kauailabs/nav6/schematics/nav6.JPG

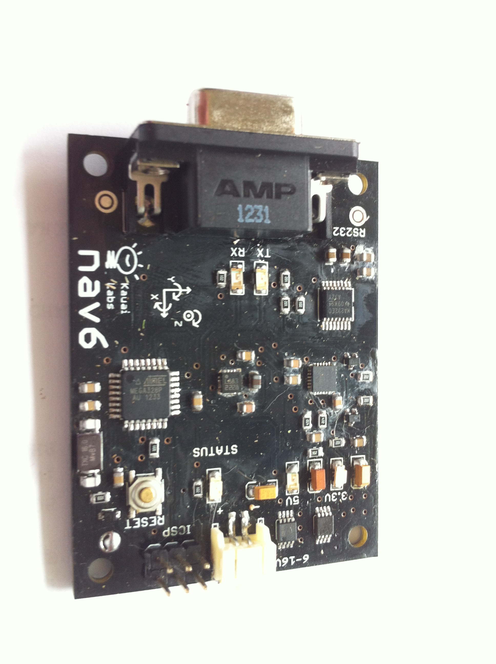
schematics/nav6.JPG
