kauailabs/nav6/images/nav6_purple_1_small_c10_highlighted.jpg

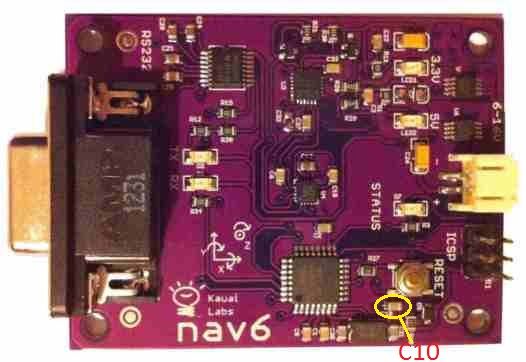
images/nav6_purple_1_small_c10_highlighted.jpg
