kauailabs/nav6/enclosure/enclosure.png

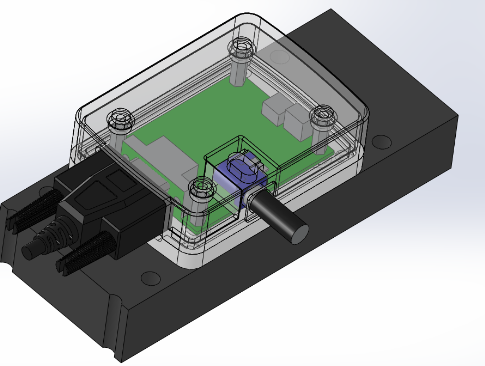
enclosure/enclosure.png
