kauailabs/nav6/enclosure/exploded.png

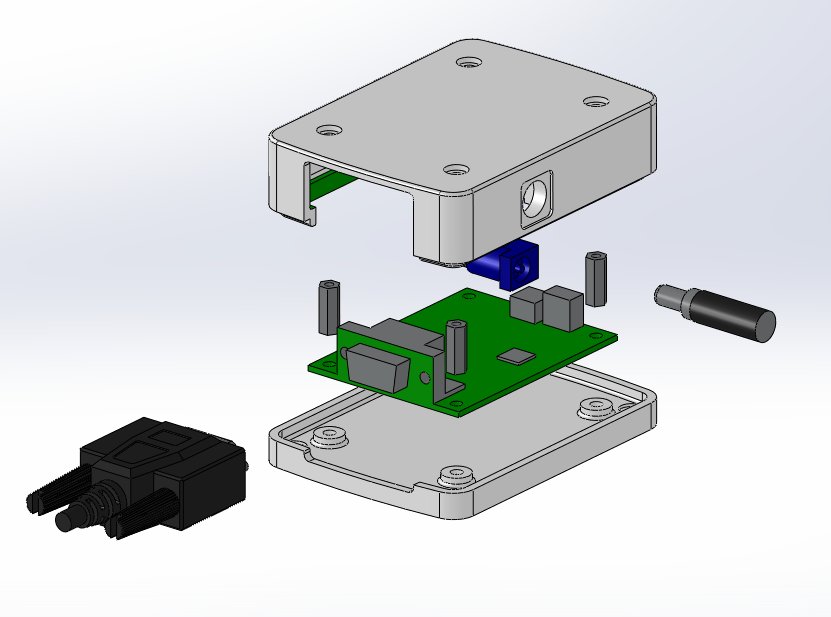
enclosure/exploded.png
