kauailabs/nav6/enclosure/exploded_angle.png

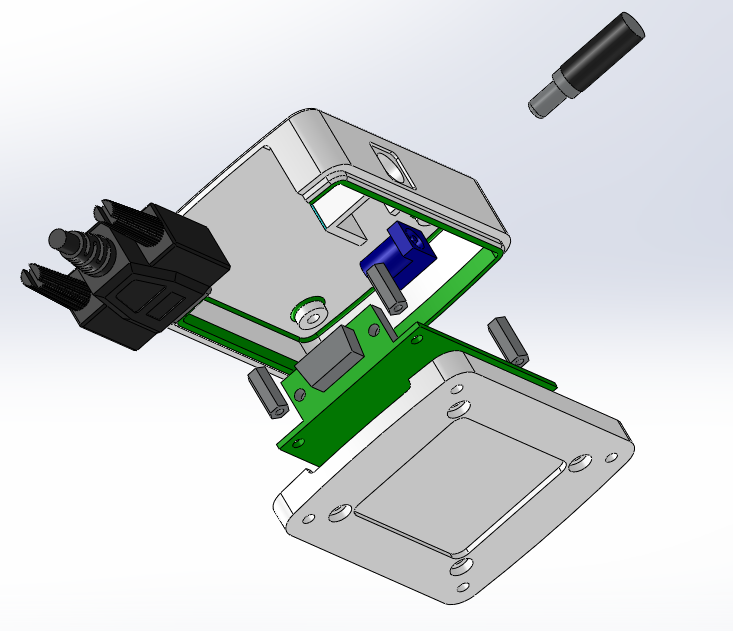
enclosure/exploded_angle.png
