kauailabs/nav6/images/db9_dtr_pin_removed.jpg

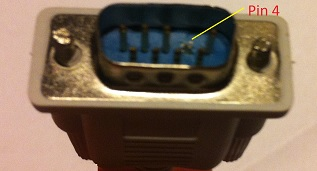
images/db9_dtr_pin_removed.jpg
