kauailabs/nav6/images/FRCMounting.png

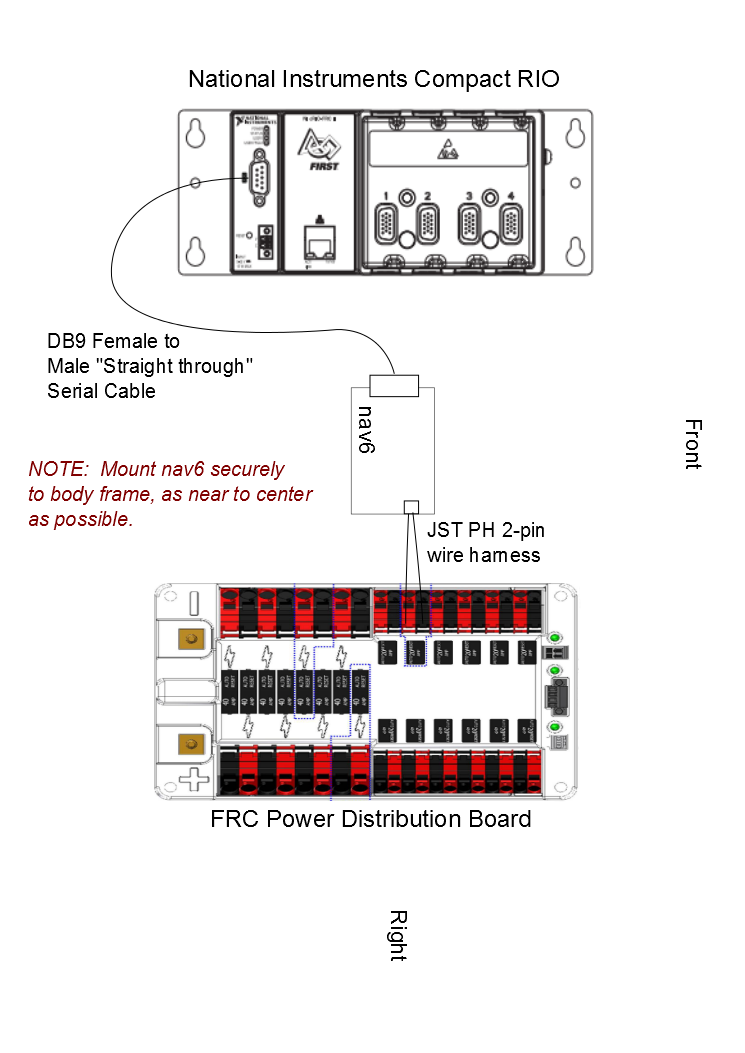
images/FRCMounting.png
