kauailabs/nav6/images/nav6_Label300.png

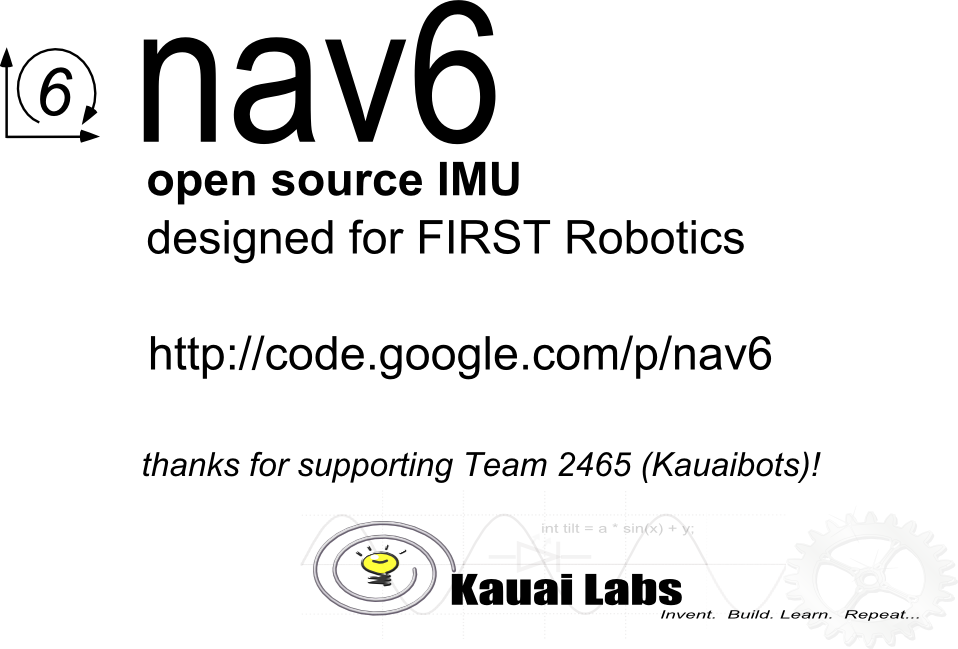
images/nav6_Label300.png
