kauailabs/nav6/images/nav6_Label.png

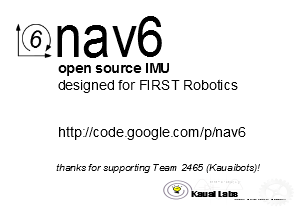
images/nav6_Label.png
