kauailabs/nav6/images/nav6UI.png

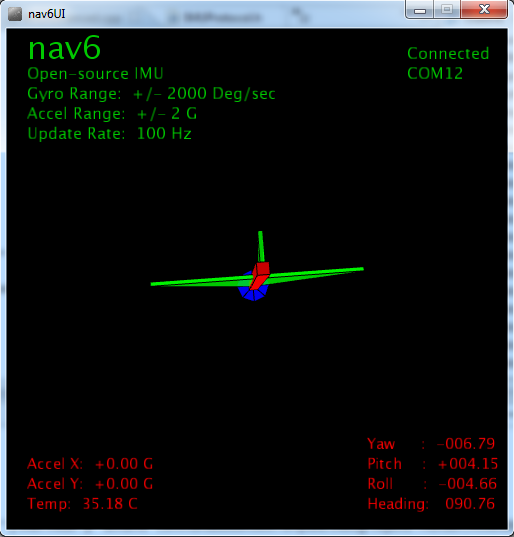
images/nav6UI.png
