kauailabs/nav6/schematics/nav6_schematic.png

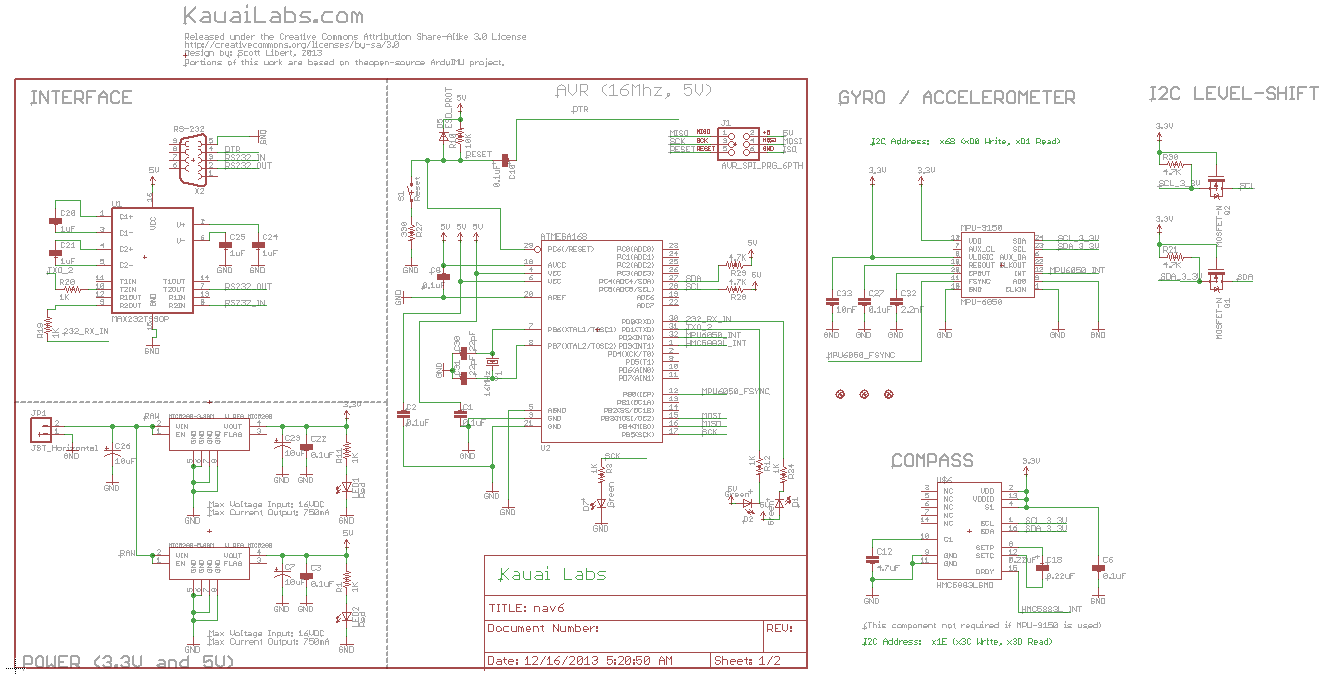
schematics/nav6_schematic.png
