kauailabs/nav6/enclosure/lid.STEP

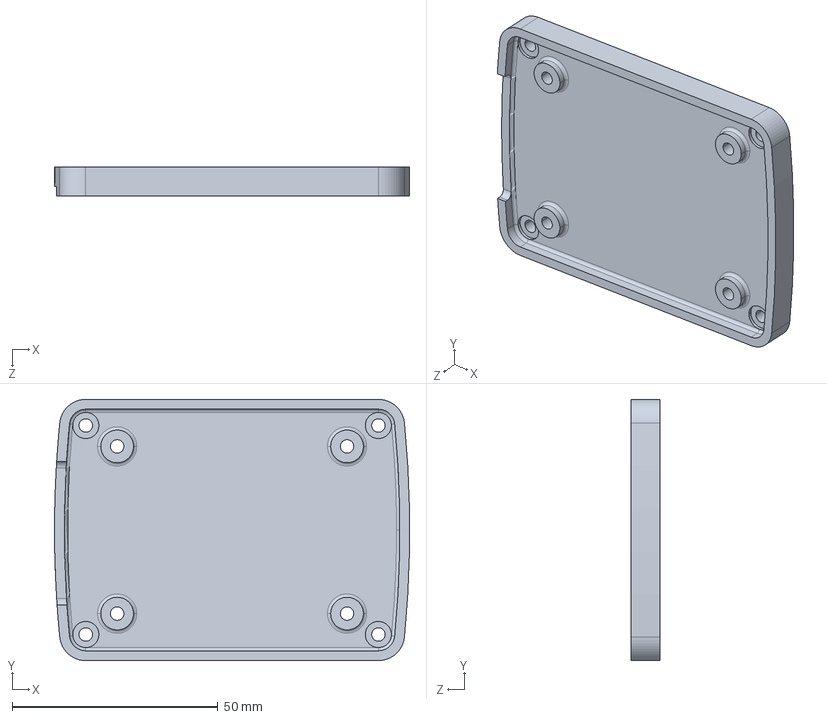
[picture p12: CAD file, 2014-02-01]
enclosure/lid.STEP
86.3 x 63.5 x 7.14 mm
