kauailabs/nav6/enclosure/base.STEP

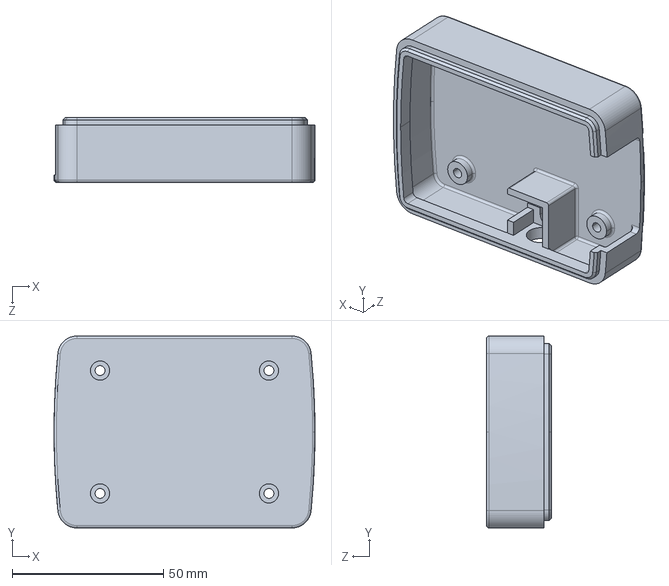
[picture p13: CAD file, 2014-02-01]
enclosure/base.STEP
86.3 x 63.5 x 21.4 mm
