kauailabs/nav6/enclosure/nav6.STL

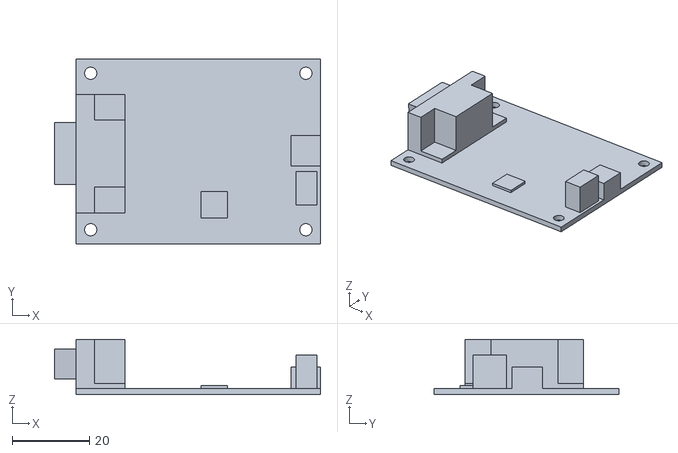
[picture p14: CAD file, 2013-12-28]
enclosure/nav6.STL
69.1 x 48.1 x 14.3
