kauailabs/nav6/(list of files, cad)

Other CAD files:
enclosure/base.STL
enclosure/lid.STL
