kauailabs/nav6/schematics/nav6.brd

## EAGLE design schematics/nav6.brd (2013-12-11)

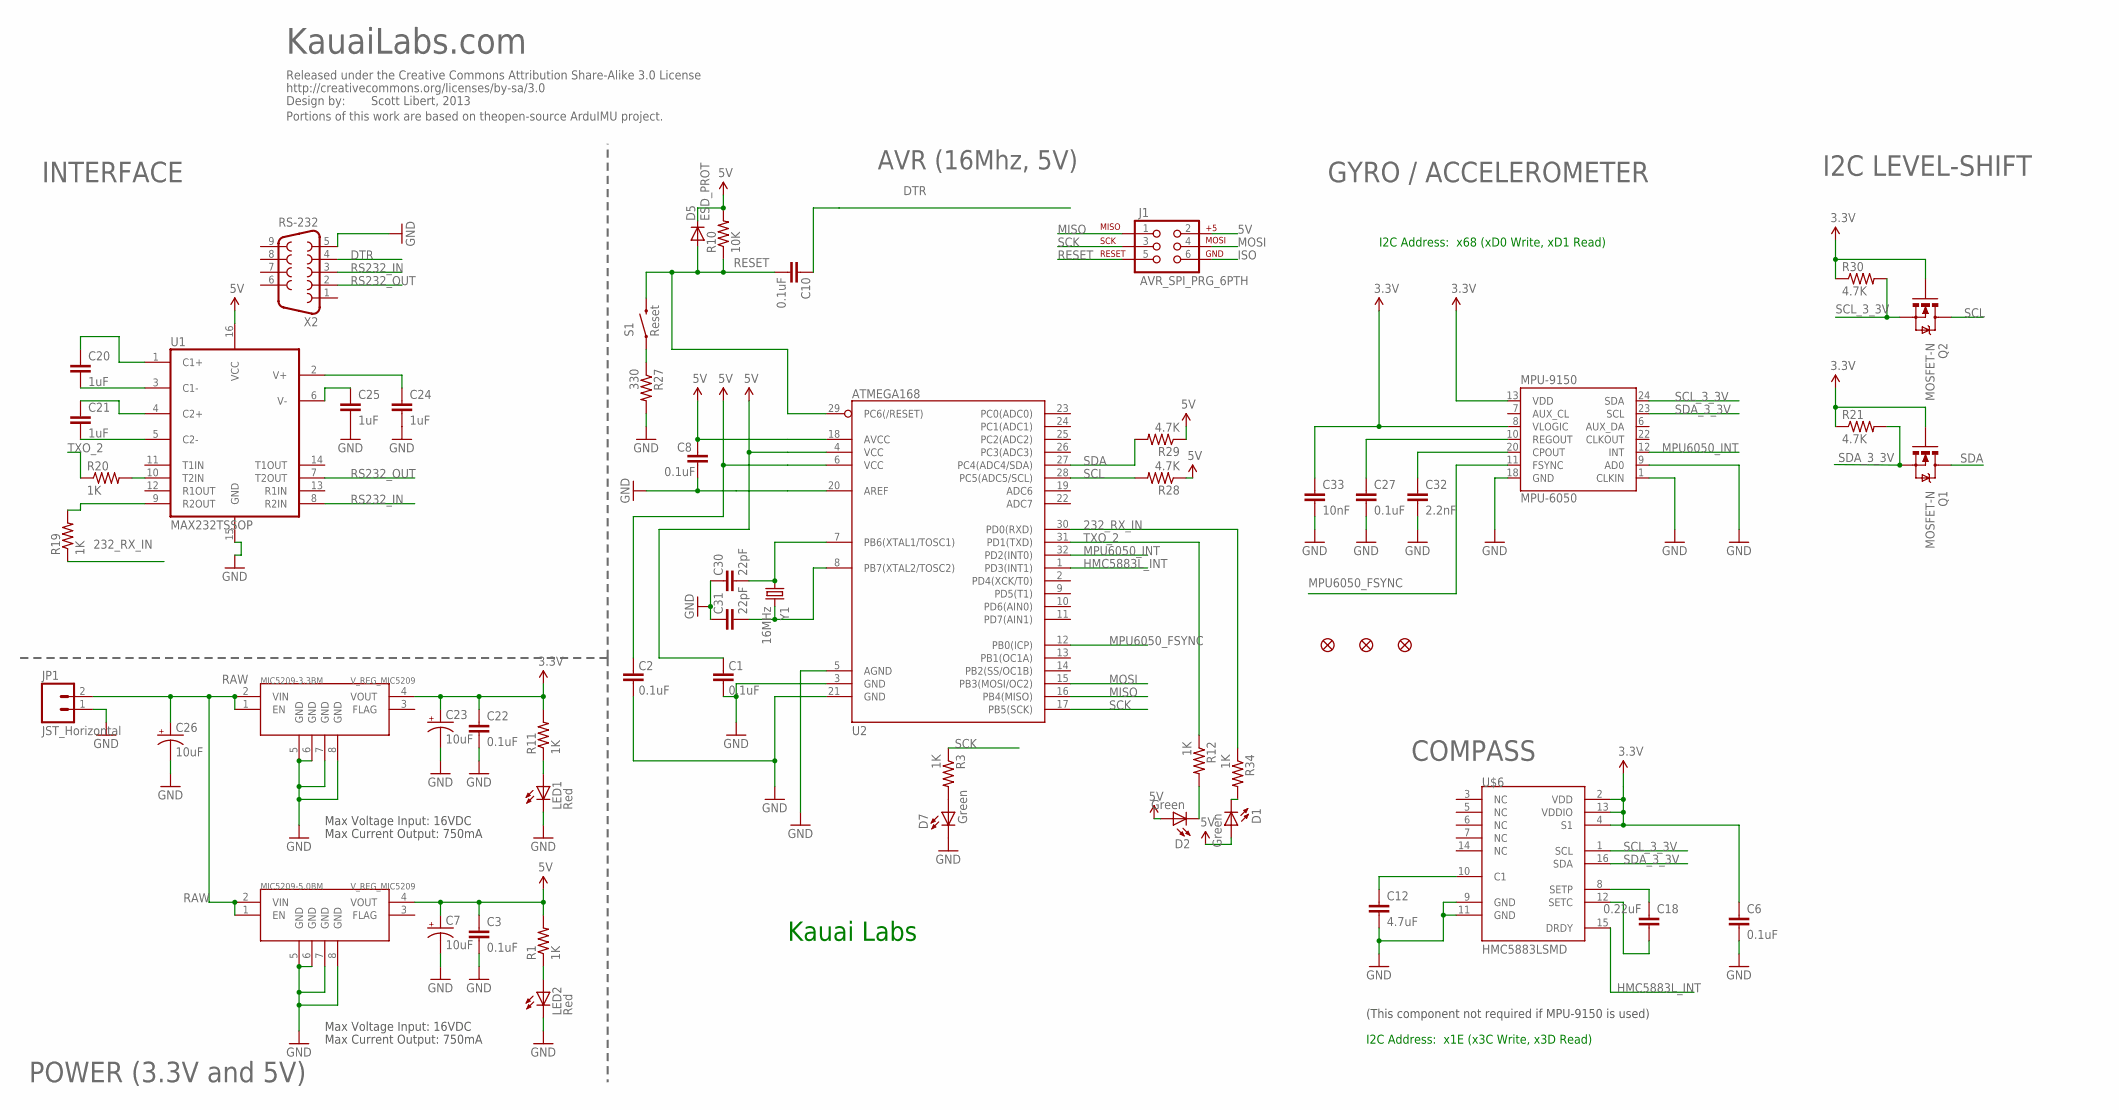
[picture p15: schematic nav6.sch, sheet 1]

Parts:
C1, C2, C3, C8, C10, C22, C27: 0.1uF; 0805
C6: 0.1uF; 0805; DIGIKEY# 445-3462-1-ND
C7, C23, C26: 10uF; EIA3216
C12: 4.7uF; 0805; DIGIKEY# 445-3457-1-ND
C18: 0.22uF; 0805; DIGIKEY# 445-1350-1-ND
C20, C21, C24, C25: 1uF; 0805
C30, C31: 22pF; 0805
C32: 2.2nF; 0805
C33: 10nF; 0805
D1, D2, D7: Green; LED-1206
D5: ESD_PROT; SOD-323
J1: AVR_SPI_PRG_6PTH; 2X3
JP1: JST_Horizontal; JST-2-SMD
JP2, JP3, JP4: FIDUCIAL1.5X3; FIDUCIAL-1.5X3
LED1, LED2: Red; LED-1206
MIC5209-3.3BM, MIC5209-5.0BM: V_REG_MIC5209; MSOP8
MPU-9150: MPU-6050; QFN24_INVENSENSE
Q1, Q2: MOSFET-N; SOT323
R1, R3, R11, R12, R19, R20, R34: 1K; 0805
R10: 10K; 0805
R21, R28, R29, R30: 4.7K; 0805
R27: 330; 0805
S1: Reset; TACTILE_SWITCH_SMD
U1: MAX232TSSOP; TSSOP16
U2: ATMEGA168; TQFP32-08
U$1: CREATIVE_COMMONS
U$6: HMC5883LSMD; 16LPCC; DIGIKEY# 342-1082-1-ND
X2: RS-232; DB9
Y1: 16MHz; CRYSTAL-TXC-7A

Connections:
3.3V: C6.1, C22.1, C23.A (+), C33.1, MIC5209-3.3BM.4 (VOUT), MPU-9150.8 (VLOGIC), MPU-9150.13 (VDD), Q1.1 (G), Q2.1 (G), R11.2, R21.1, R30.1, U$6.2 (VDD), U$6.4 (S1), U$6.13 (VDDIO)
5V: C1.2, C2.2, C3.1, C7.A (+), C8.2, D1.A, D2.A, D5.1 (C), J1.2, MIC5209-5.0BM.4 (VOUT), R1.2, R10.2, R28.1, R29.1, U1.16 (VCC), U2.4 (VCC), U2.6 (VCC), U2.18 (AVCC)
232_RX_IN: R19.1, R34.1, U2.30 (PD0(RXD))
DTR: C10.2, X2.4
HMC5883L_INT: U2.1 (PD3(INT1)), U$6.15 (DRDY)
ISO: C1.1, C2.1, C3.2, C6.2, C7.C (-), C8.1, C12.2, C22.2, C23.C (-), C24.2, C25.2, C26.C (-), C27.2, C30.2, C31.2, C32.2, C33.2, D7.C, J1.6, JP1.1, LED1.C, LED2.C, MIC5209-3.3BM.5 (GND), MIC5209-3.3BM.6 (GND), MIC5209-3.3BM.7 (GND), MIC5209-3.3BM.8 (GND), MIC5209-5.0BM.5 (GND), MIC5209-5.0BM.6 (GND), MIC5209-5.0BM.7 (GND), MIC5209-5.0BM.8 (GND), MPU-9150.1 (CLKIN), MPU-9150.9 (AD0), MPU-9150.18 (GND), R27.2, U1.15 (GND), U2.3 (GND), U2.5 (AGND), U2.20 (AREF), U2.21 (GND), U$6.9 (GND), U$6.11 (GND), X2.5
MISO: J1.1, U2.16 (PB4(MISO))
MOSI: J1.4, U2.15 (PB3(MOSI/OC2))
MPU6050_FSYNC: MPU-9150.11 (FSYNC), U2.12 (PB0(ICP))
MPU6050_INT: MPU-9150.12 (INT), U2.32 (PD2(INT0))
unnamed: C30.1, U2.7 (PB6(XTAL1/TOSC1)), Y1.P$1 (1)
unnamed: C32.1, MPU-9150.20 (CPOUT)
unnamed: LED2.A, R1.1
unnamed: C18.2, U$6.8 (SETP)
unnamed: C18.1, U$6.12 (SETC)
unnamed: C12.1, U$6.10 (C1)
unnamed: D1.C, R34.2
unnamed: D7.A, R3.2
unnamed: D2.C, R12.2
unnamed: C24.1, U1.2 (V+)
unnamed: C25.1, U1.6 (V-)
unnamed: LED1.A, R11.1
unnamed: C20.1, U1.1 (C1+)
unnamed: C20.2, U1.3 (C1-)
unnamed: C21.1, U1.4 (C2+)
unnamed: C21.2, U1.5 (C2-)
unnamed: C27.1, MPU-9150.10 (REGOUT)
unnamed: R19.2, U1.9 (R2OUT)
unnamed: R20.2, U1.10 (T2IN)
unnamed: R27.1, S1.1
unnamed: C31.1, U2.8 (PB7(XTAL2/TOSC2)), Y1.P$2 (2)
RAW: C26.A (+), JP1.2, MIC5209-3.3BM.1 (EN), MIC5209-3.3BM.2 (VIN), MIC5209-5.0BM.1 (EN), MIC5209-5.0BM.2 (VIN)
RESET: C10.1, D5.2 (A), J1.5, R10.1, S1.3 (2), U2.29 (PC6(/RESET))
RS232_IN: U1.8 (R2IN), X2.3
RS232_OUT: U1.7 (T2OUT), X2.2
SCK: J1.3, R3.1, U2.17 (PB5(SCK))
SCL: Q2.3 (D), R28.2, U2.28 (PC5(ADC5/SCL))
SCL_3_3V: MPU-9150.23 (SCL), Q2.2 (S), R30.2, U$6.1 (SCL)
SDA: Q1.3 (D), R29.2, U2.27 (PC4(ADC4/SDA))
SDA_3_3V: MPU-9150.24 (SDA), Q1.2 (S), R21.2, U$6.16 (SDA)
TXO_2: R12.1, R20.1, U2.31 (PD1(TXD))

Notes on the sheet:
Max Voltage Input: 16VDC
Max Current Output: 750mA
AVR (16Mhz, 5V)
INTERFACE
POWER (3.3V and 5V)
Kauai Labs
I2C LEVEL-SHIFT
GYRO / ACCELEROMETER
I2C Address: x68 (xD0 Write, xD1 Read)
(This component not required if MPU-9150 is used)
COMPASS
I2C Address: x1E (x3C Write, x3D Read)
KauaiLabs.com
Scott Libert, 2013
Portions of this work are based on theopen-source ArduIMU project.

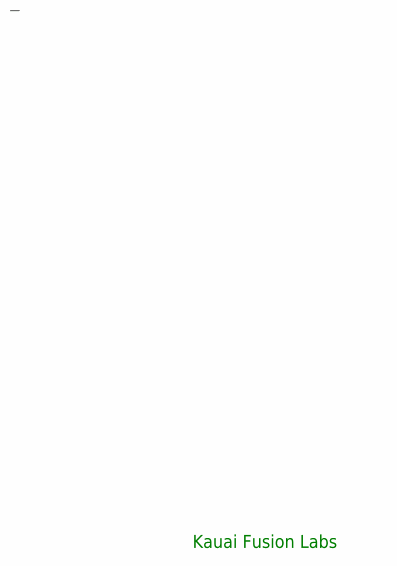
[picture p16: schematic nav6.sch, sheet 2]

Notes on the sheet:
Kauai Fusion Labs

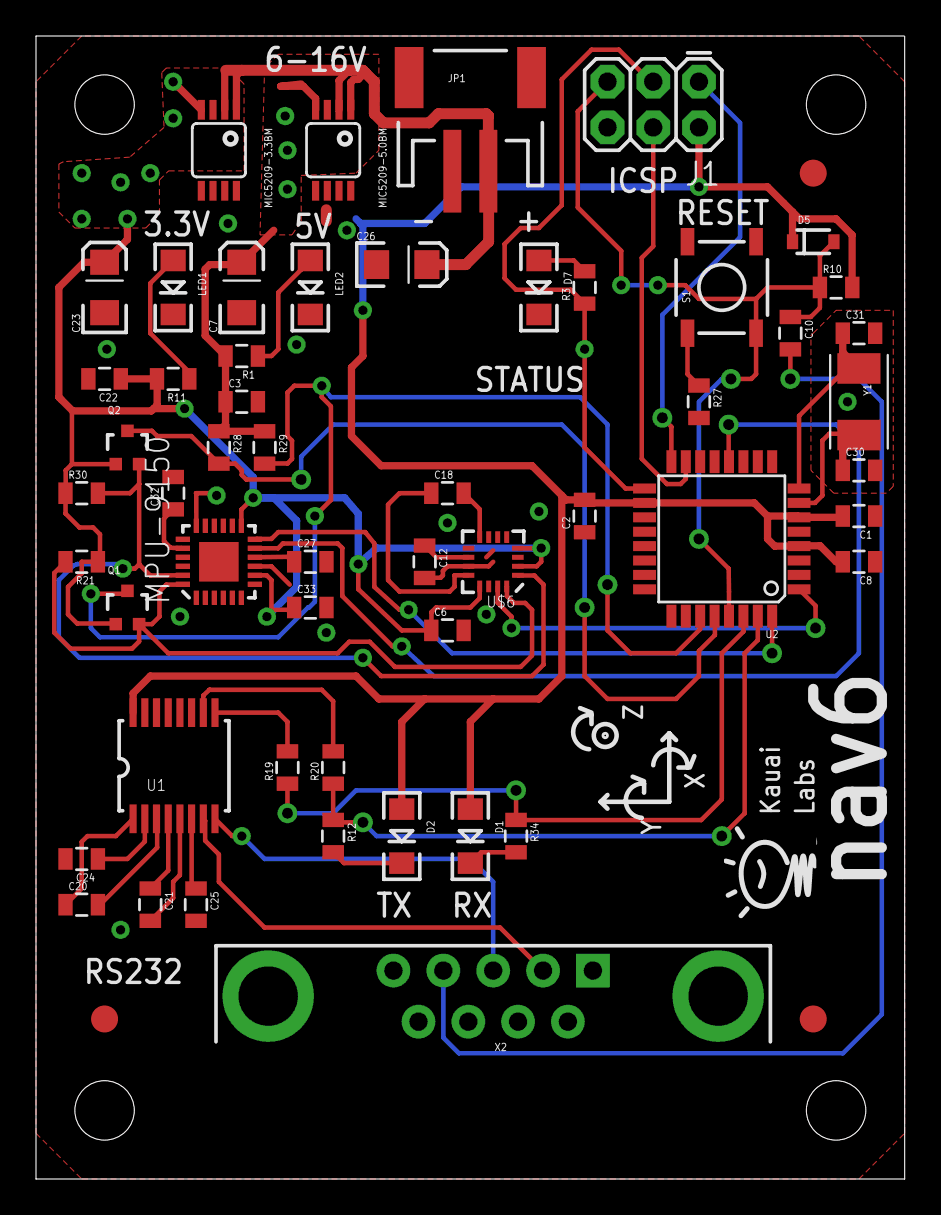
[picture p17: board nav6.brd from above]

Board: 2 copper layers, 48.3 x 63.5 mm, 61 parts (0 on the bottom side), 41 nets.

Other parts of the board:
U$2, U$3, U$4, U$8: STAND-OFF
