kauailabs/nav6/roborio/c++/nav6_CPlusPlus_RobotExample/src/IMUAdvanced.h

/*----------------------------------------------------------------------------*/
/* Copyright (c) Kauai Labs. All Rights Reserved.							  */
/*                                                                            */
/* Created in support of Team 2465 (Kauaibots).  Go Thunderchicken!           */
/*                                                                            */
/* Based upon the Open Source WPI Library released by FIRST robotics.         */
/* Open Source Software - may be modified and shared by FRC teams. The code   */
/* must be accompanied by the FIRST BSD license file in $(WIND_BASE)/WPILib.  */
/*----------------------------------------------------------------------------*/

#ifndef IMUADVANCED_H_
#define IMUADVANCED_H_

#include "IMU.h"
/**
 * Use the IMU to retrieve a Yaw/Pitch/Roll measurement.
 * 
 * This utilizes the Kauai Labs Nav6 IMU.
 * 
 * This IMU interfaces to the CRio processor via a Serial port.
 * 
 * This is the "advanced" version of the IMU class, which uses the
 * nav6 "Raw" messages, adding these additional features:
 * 
 * - calculate world-frame linear acceleration (gravity-removed)
 * - monitor the temperature of the Invensense sensor
 * - detection of motion/no-motion
 * 
 * Note that these additional features come at the expense of some
 * additional processing.
 */

#define WORLD_LINEAR_ACCEL_HISTORY_LENGTH 10

class IMUAdvanced : public IMU
{
public:

	IMUAdvanced( SerialPort *pport, uint8_t update_rate_hz = 100 );
	virtual ~IMUAdvanced();
	
	virtual float GetWorldLinearAccelX();
	virtual float GetWorldLinearAccelY();
	virtual float GetWorldLinearAccelZ();
	virtual bool  IsMoving();
	virtual float GetTempC();
		
	void SetQuaternion( int16_t q1, int16_t q2, int16_t q3, int16_t q4,
						int16_t accel_x, int16_t accel_y, int16_t accel_z,
						int16_t mag_x, int16_t mag_y, int16_t mag_z,
						float temp_c);

protected:
	
	int DecodePacketHandler( char *received_data, int bytes_remaining );
	
private:
	void InitIMU();
	void InitWorldLinearAccelHistory();
	void UpdateWorldLinearAccelHistory( float x, float y, float z );
	float GetAverageFromWorldLinearAccelHistory();

	float   world_linear_accel_x;
	float   world_linear_accel_y;
	float   world_linear_accel_z;
	float   temp_c;
	float 	world_linear_accel_history[WORLD_LINEAR_ACCEL_HISTORY_LENGTH];
	int 	next_world_linear_accel_history_index;
	float	world_linear_acceleration_recent_avg;

};
#endif
