kauailabs/nav6/(commit log)

2013-08-11 Initial Checkin
    [nav6.brd, nav6.sch, nav6_bom.csv]
2013-12-11 Fixed up the headers in the file to reflect correct licensing information and attribution.
    [nav6.brd, nav6.sch]
2013-12-19 Added Invensense Motion Driver v. 5.1, ported to Arduino
2013-12-28 Added new code based on official Invensense Motion Driver v. 5.1
2013-12-28 Moved IMUProtocol.h to new nav6 library directory
2013-12-28 Removed copied version of IMUProtocol.h from nav6_old; moved IMUProtocol.h.old to nav6 library. Added license to nav6.ino
2013-12-28 renamed from IMU_Protocol
2013-12-30 Removed IMUProtocoltestOld
2014-01-01 Added manual I2C bus reset to startup to ensure I2C bus devices are not stuck attempt to complete a transfer that started, but didn't complete, when the ATMEGA328 processor was reset.
    [nav6.ino]
2014-01-01 Updated IMUProtocol.h file to fix exception case.
    [IMUProtocol.h]
2014-01-02 Added calibrated quaternion offsets to stream response message
2014-01-02 updated nav6.jar to include changes to add calibrated quaternion offsets to protocol
2014-01-02 Added world accel display to UI; integrated with updated nav6.jar that contains new calibrated quaternion offsets.
2014-01-03 Added new IMUAdvanced class
2014-01-07 Cleaned up code/comments. Added nav6 status led updating code in case of failure to intialize. Increased number of i2c bits clocked during I2C reset. Added calculation of world linear acceleration to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
    [IMUAdvanced.cpp, IMUAdvanced.h, nav6.ino, version.h]
2014-01-07 Added display of world linear acceleration in Z Axis
2014-01-08 Fixed bug in IMU class constructor; modified Thread constructor invocation to take 'this' (IMU class instance reference) as a paramter
2014-01-09 Added new 'Gyro' Update message'
2014-01-09 Added Support for new 'Gyro' update message
2014-01-12 Fixed bugs in code/comments regarding the type of update message used in basic and advanced cases
    [IMU.cpp]
2014-01-12 modifed setDTR() parameter from false to true, to help avoid issues experienced when resetting the nav6 Atmega processor [the MPU6050 sometimes hangs on re-initialization] via the Serial port DTR lin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
    [nav6UI.pde]
2014-01-18 Fixes based on issues found/reported by Will Marshall (Team 11). Fixed bug in initIMU to ensure world linear history was initialized. Modified visibility of certain methods. Refactored run() methods 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
2014-01-20 Added code to IMU.java to reset the serial port in case garbage is received; this case is seen sometimes and needs to be cleared.
2014-01-20 Updated to latest build including fixes to IMU.java to deal with serial port issues
2014-01-20 Added support for waiting 2 seconds, then sending stream configuration request. Also, added code to IMUAdvanced to mirror IMU, resetting the serial port if it gest into a bad state. Also, removed the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
2014-01-20 Updated java sample code after testing w/latest IMU and IMU Advanced classes.
2014-01-20 Added code to handle cases where contact is lost w/the nav6; the thread run() method periodically checks to see if new data has arrived. If so, it sends out the stream reconfiguration message.
2014-01-20 Fixed bugs related to chagnes in the C++ version of the WPI Library and/or the VISA layer that was causing exceptions when high data rates (100hz) are used. Also updated to match the code in the Java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
    [IMU.cpp, IMU.h, IMUAdvanced.cpp, IMUAdvanced.h]
2014-01-21 Fixed bug by adding call of UpdateYawHistory() from within the IMUAdvanced class
    [IMU.h, IMUAdvanced.cpp]
2014-01-21 Fixed issue with updating of yaw history from within IMUAdvanced class
2014-01-21 Fixed some bugs in the IMUAdvanced class
    [IMU.cpp, IMU.h, IMUAdvanced.cpp, IMUAdvanced.h, IMUProtocol.h]
2014-01-21 Modified decodeQuaternion function to use signed rather than unsigned values for the quaternion and accelerometer data.
2014-01-22 Updated sample code to wait until calibration is complete and then zero the yaw
2014-01-23 Recover from cable disconnect or power outage. Reduce CPU usage with low update rates. Fix application build error.
2014-01-23 Fixed IsCalibrating() to work correctly; added it to the simple robot program
    [IMUAdvanced.cpp]
2014-01-23 Moved IsCalibrating() method to base IMU class.
2014-01-29 Modified to use isCalibration() for IMU class, now that this method is in the base class
2014-01-29 Fixed a few issues reported by Will Martin
    [IMU.cpp, IMUAdvanced.cpp]
2014-01-29 Modified to match modified IMUProtocol interface changes
2014-01-29 Updated to match changes in interface to IMUProtocol class
2014-02-01 Added new STEP files and PNGs
    [base.STEP, lid.STEP]
2014-02-01 Fixed bug that was causing crashes when connection was lost
    [IMU.cpp]
2014-05-23 Added PNG version of the schematic
2014-12-02 Added Java IMU class, which has been tested w/the new RoboRIO Beta WPI Libraries. Modification/testing performed by Joe Ross.
2015-01-04 Adding RoboRio-ported versions of the LabView, C++ and Java client-side libraries and sample code for a FRC Robot.
2015-01-04 Removed a navx-mxp file from the nav6 sample code.
